hww/SndSynt/doc/pictures/Cartrige Note.gif

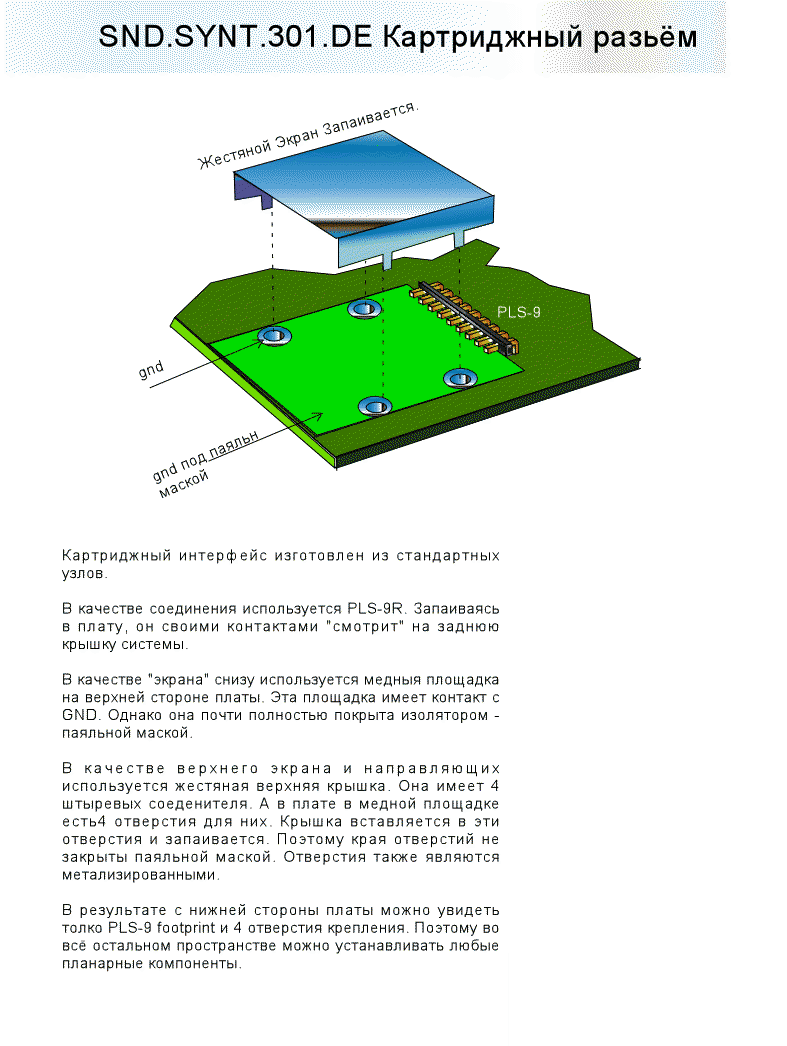
doc/pictures/Cartrige Note.gif
