hww/SndSynt/doc/pictures/FrontPanelDecalA.GIF

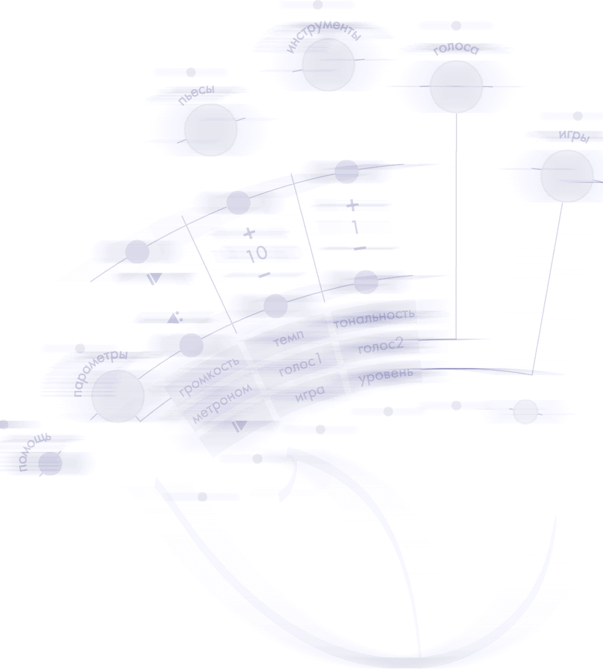
doc/pictures/FrontPanelDecalA.GIF
