hww/SndSynt/doc/pictures/FrontPanelDecalB.GIF

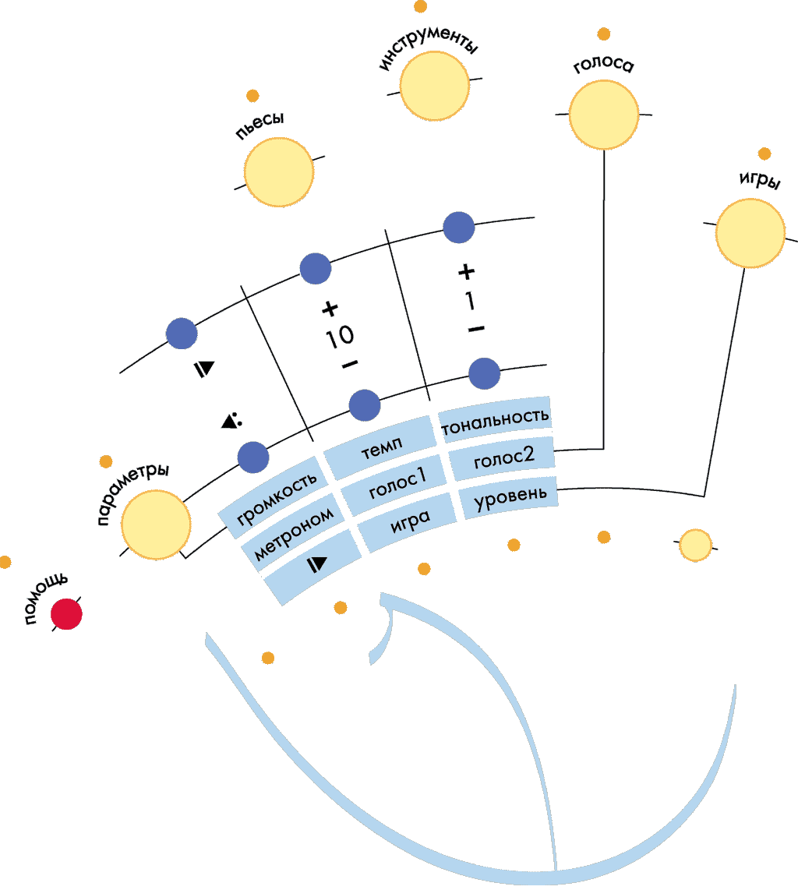
doc/pictures/FrontPanelDecalB.GIF
