hww/SndSynt/doc/pictures/PCB Photo.jpg

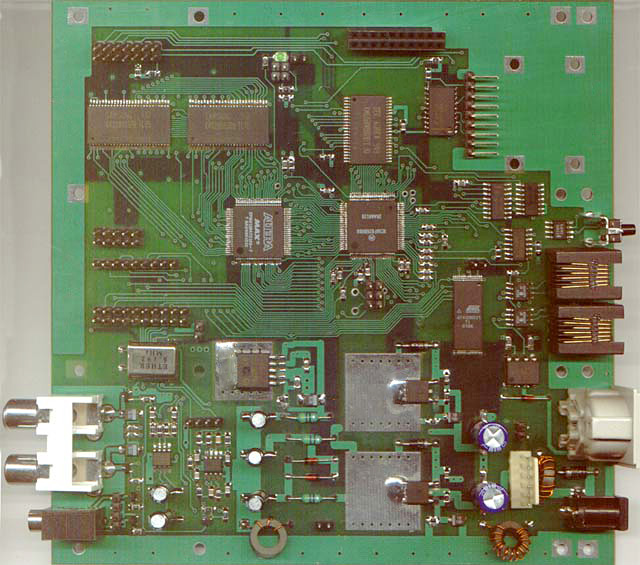
doc/pictures/PCB Photo.jpg
