hww/SndSynt/doc/pdf/logo.pdf

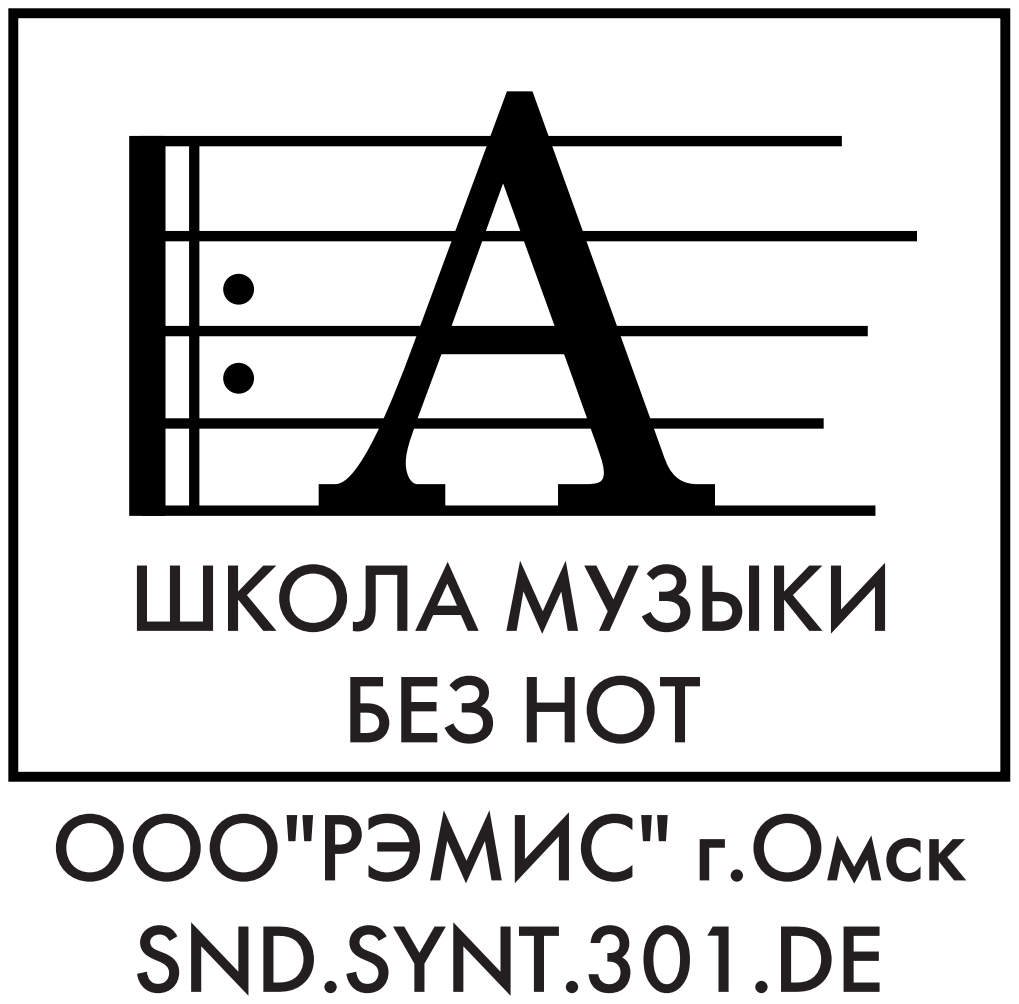
[picture p7: page 1]
