hww/SndSynt/doc/pdf/pkg_SWT157.pdf

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

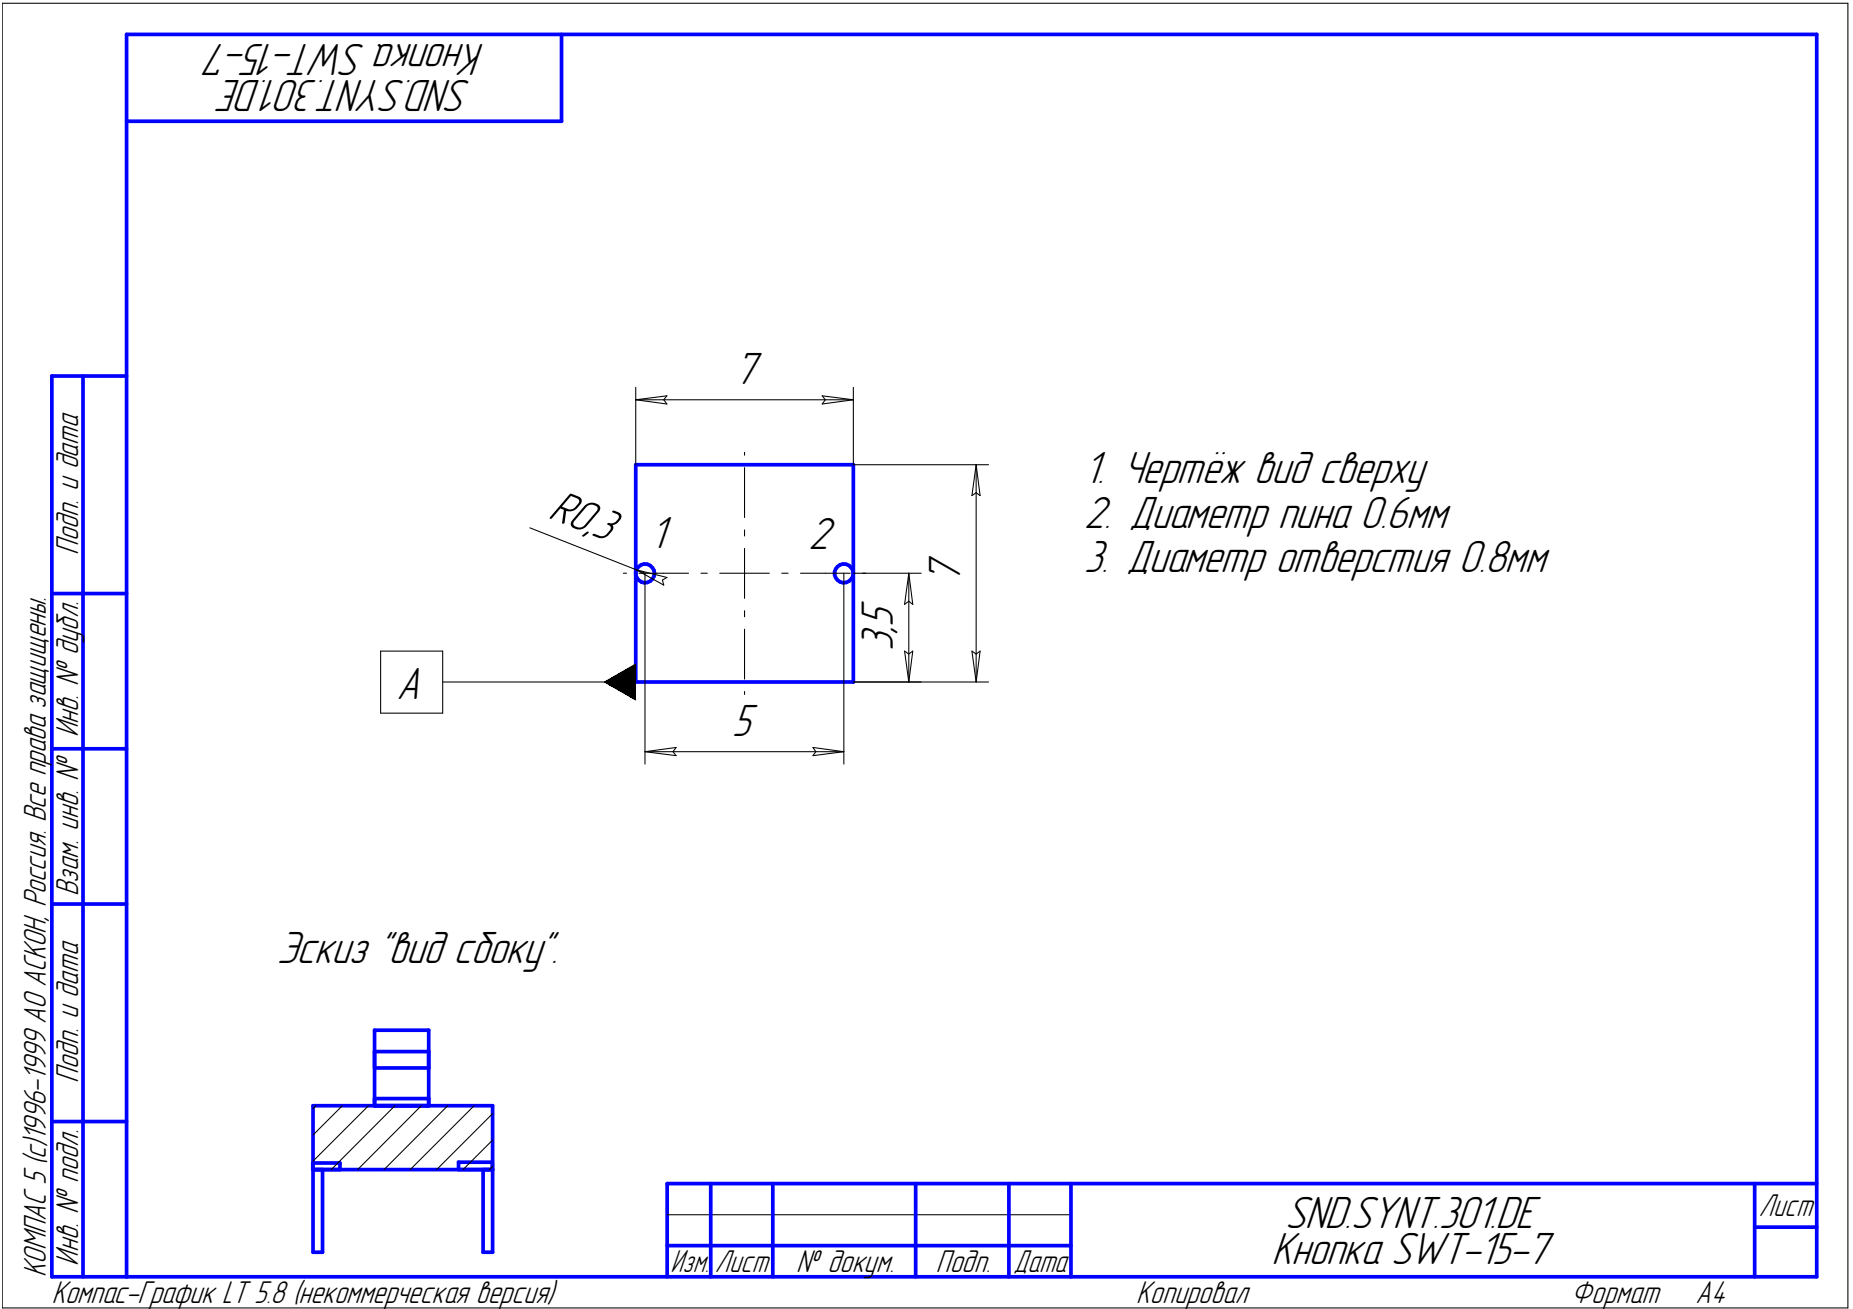
[picture p8: page 1]
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
