hww/SndSynt/doc/TimeDiagrams/sdram_rf_v7.pdf

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

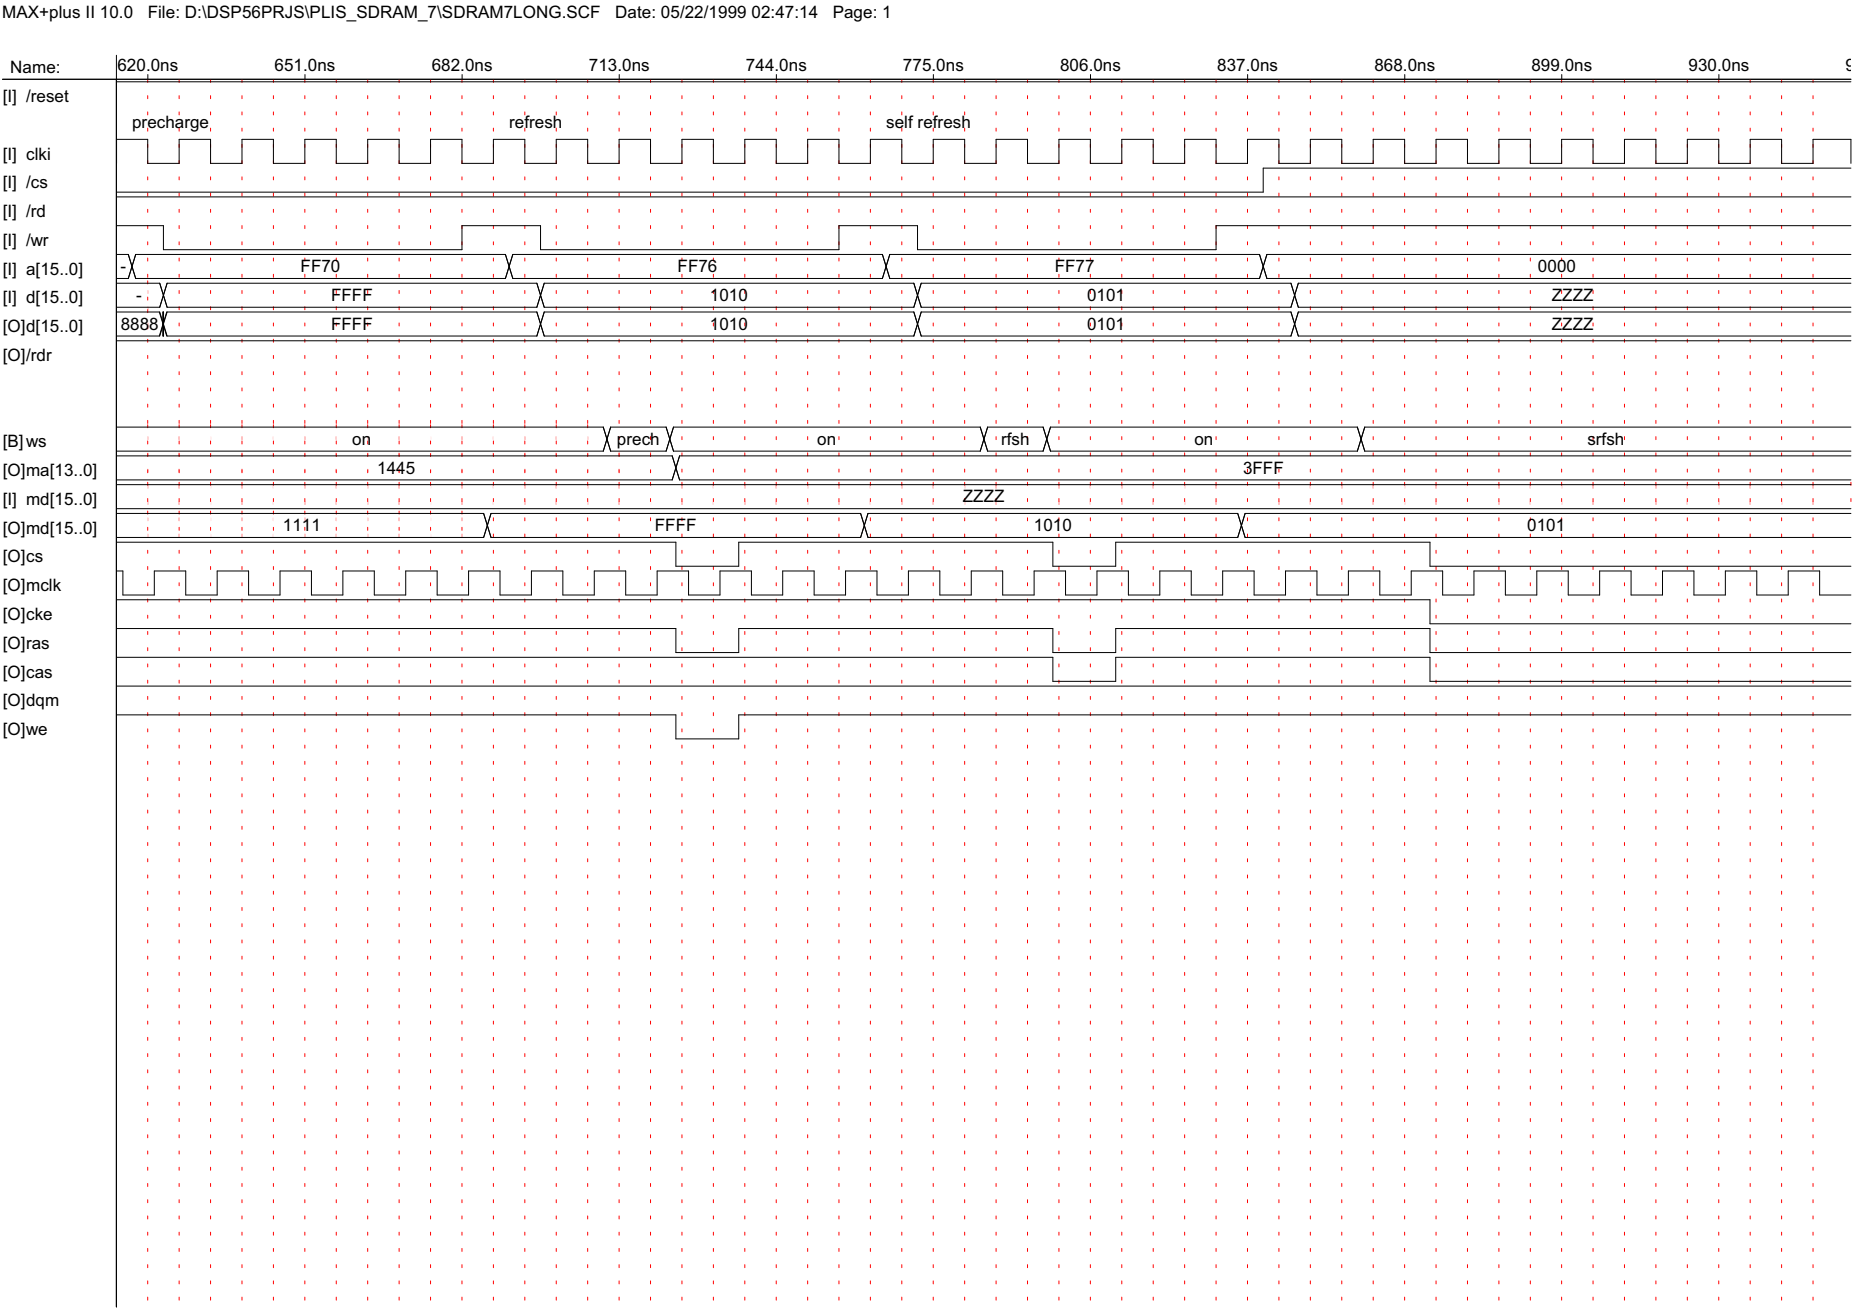
[picture p11: page 1]
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
