hww/SndSynt/doc/pdf/sch/P-CAD EDA - [AMPLIFER].pdf

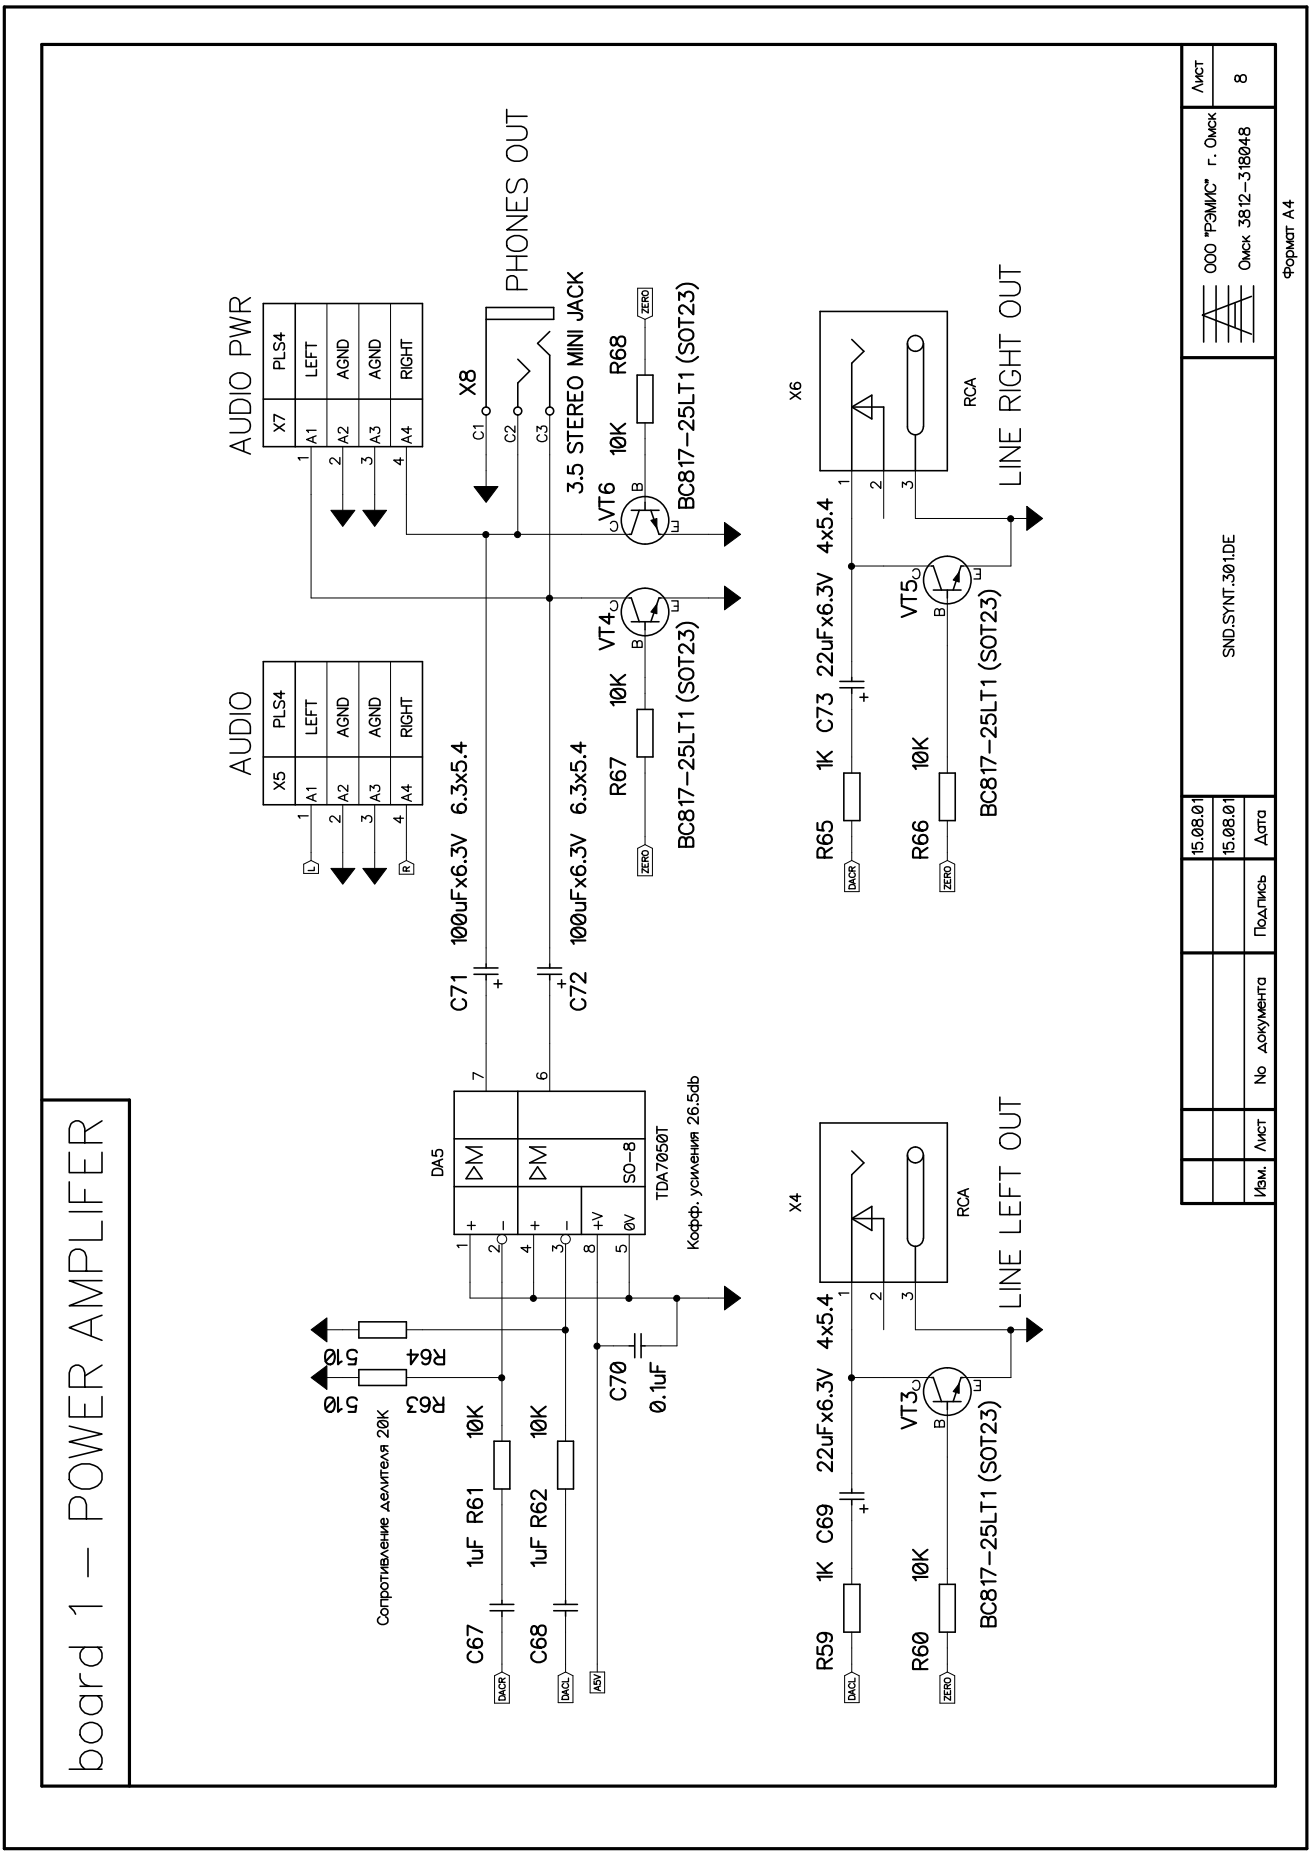
[picture p12: page 1]
