hww/SndSynt/doc/pdf/sch/P-CAD EDA - [CONNECT].pdf

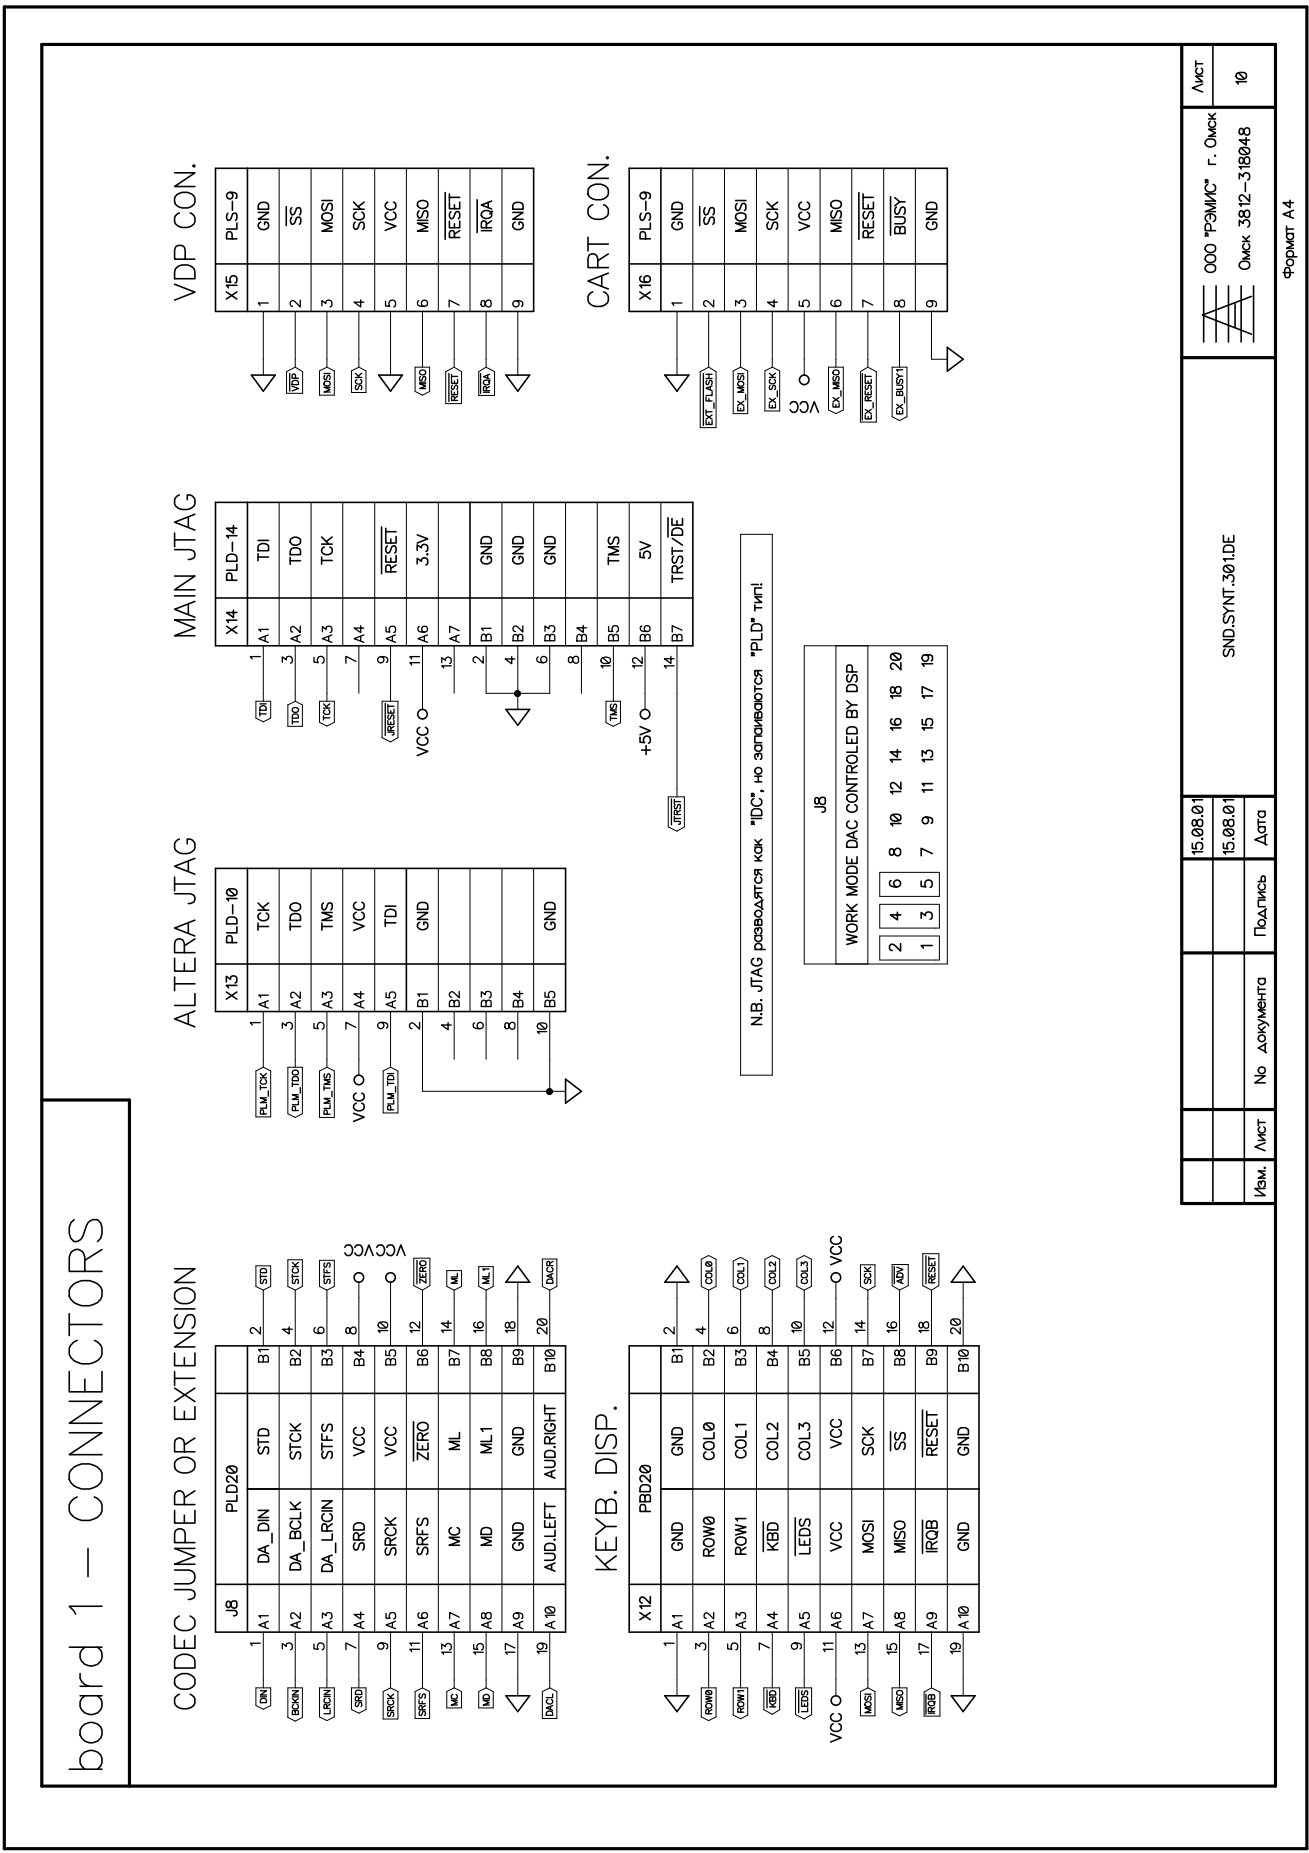
[picture p13: page 1]
