hww/SndSynt/doc/pdf/sch/P-CAD EDA - [DA].pdf

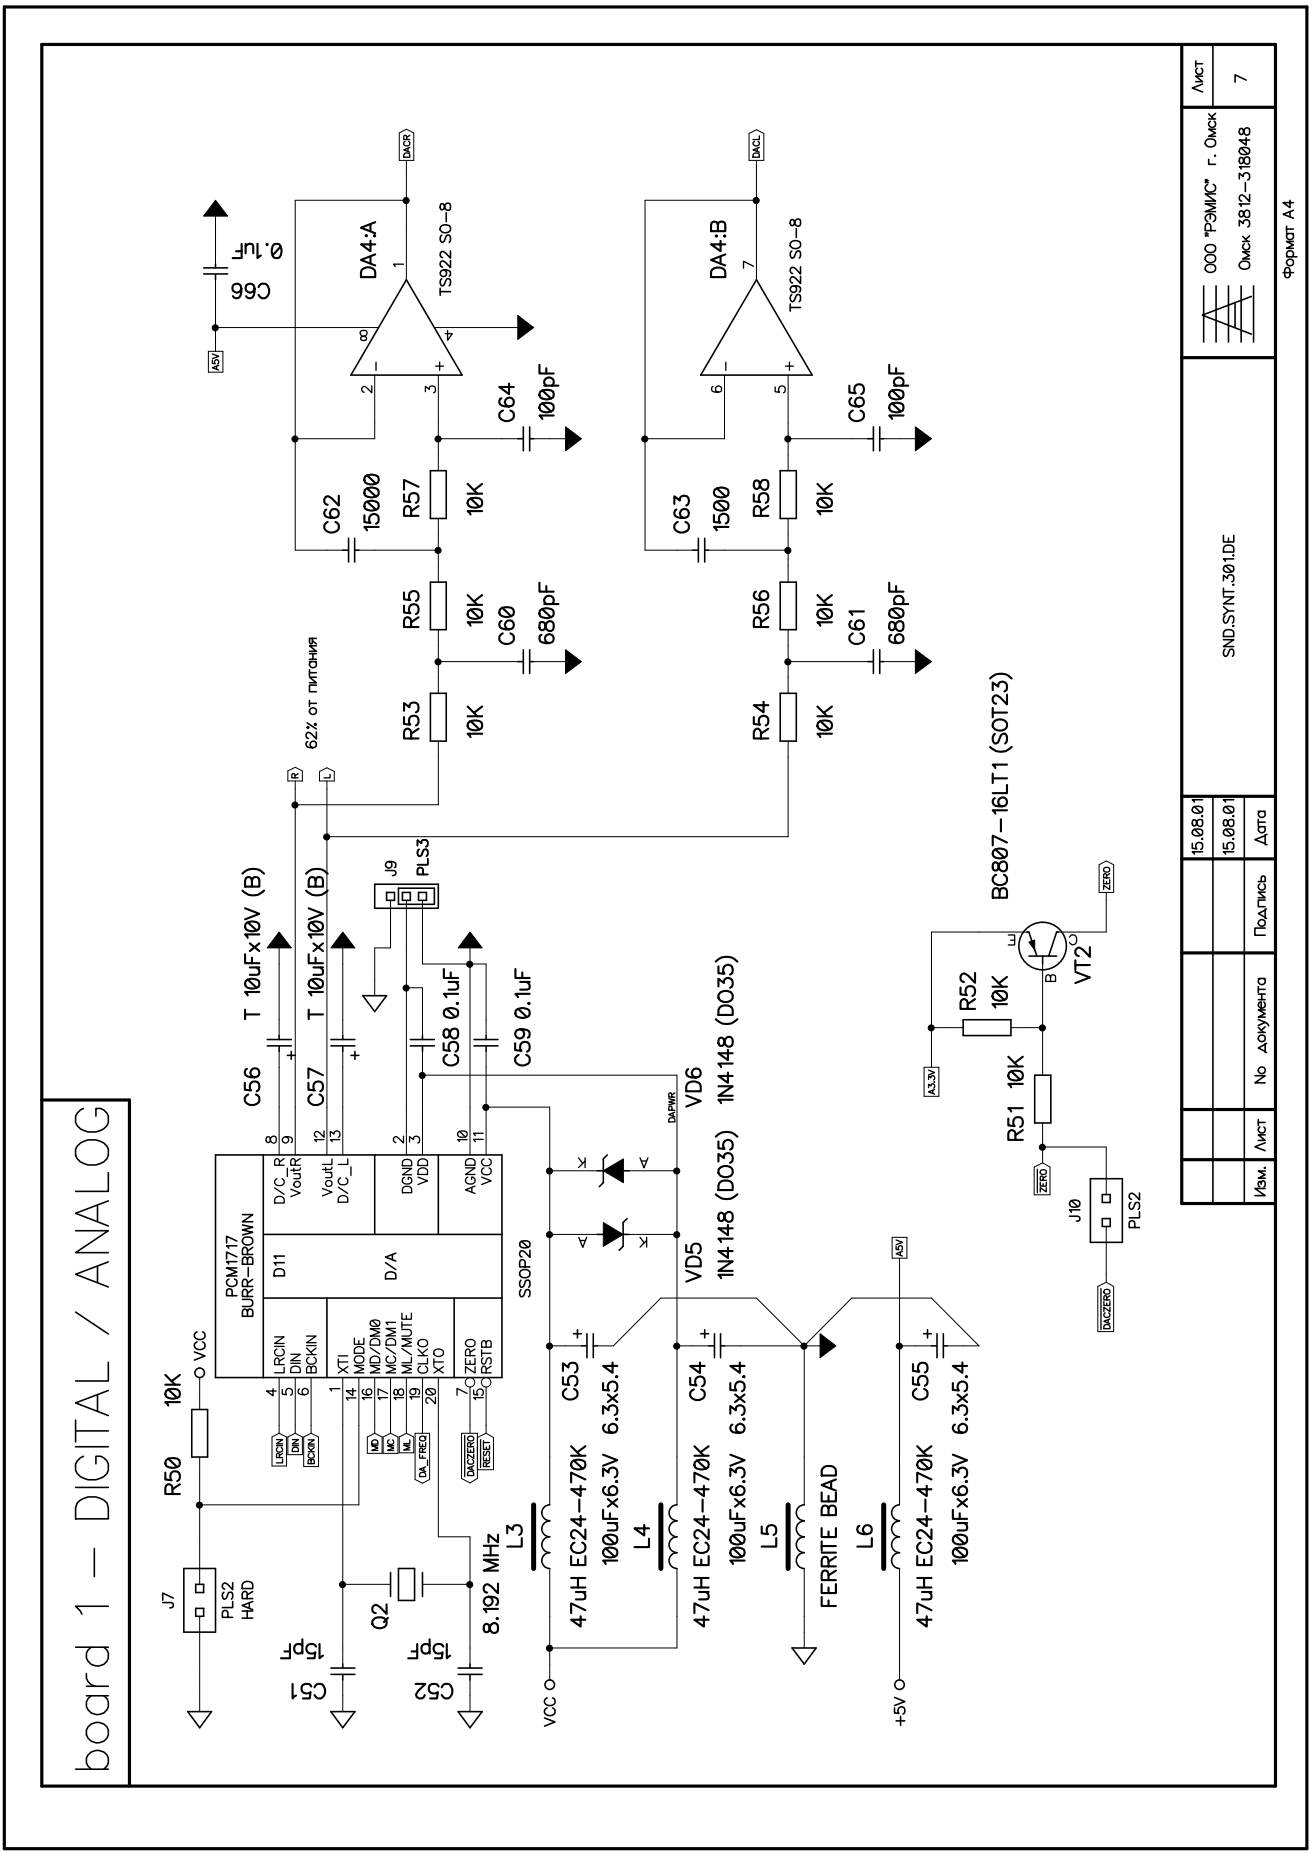
[picture p14: page 1]
