hww/SndSynt/doc/pdf/sch/P-CAD EDA - [DSP].pdf

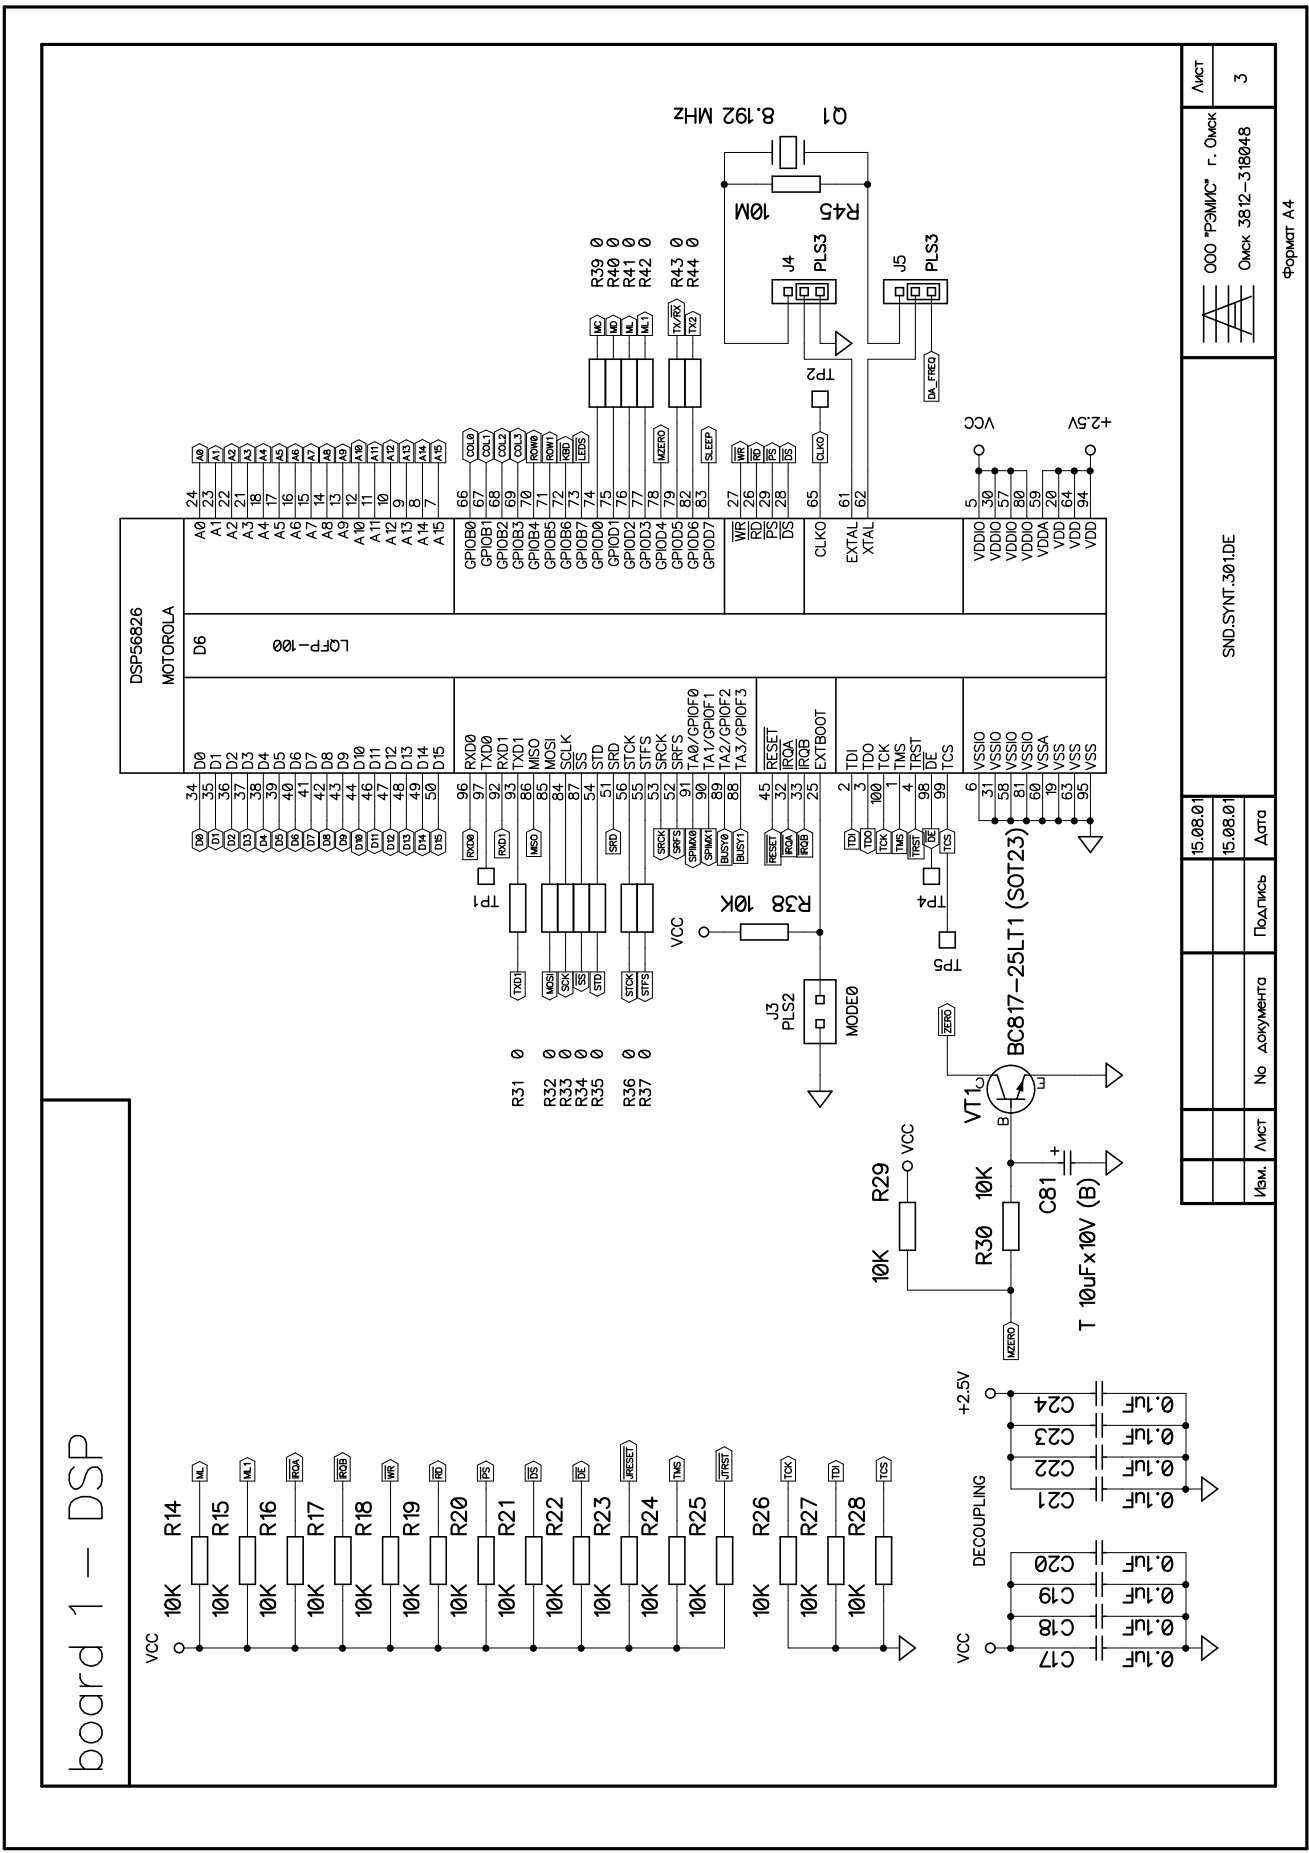
[picture p15: page 1]
