hww/SndSynt/doc/pdf/sch/P-CAD EDA - [GLUE].pdf

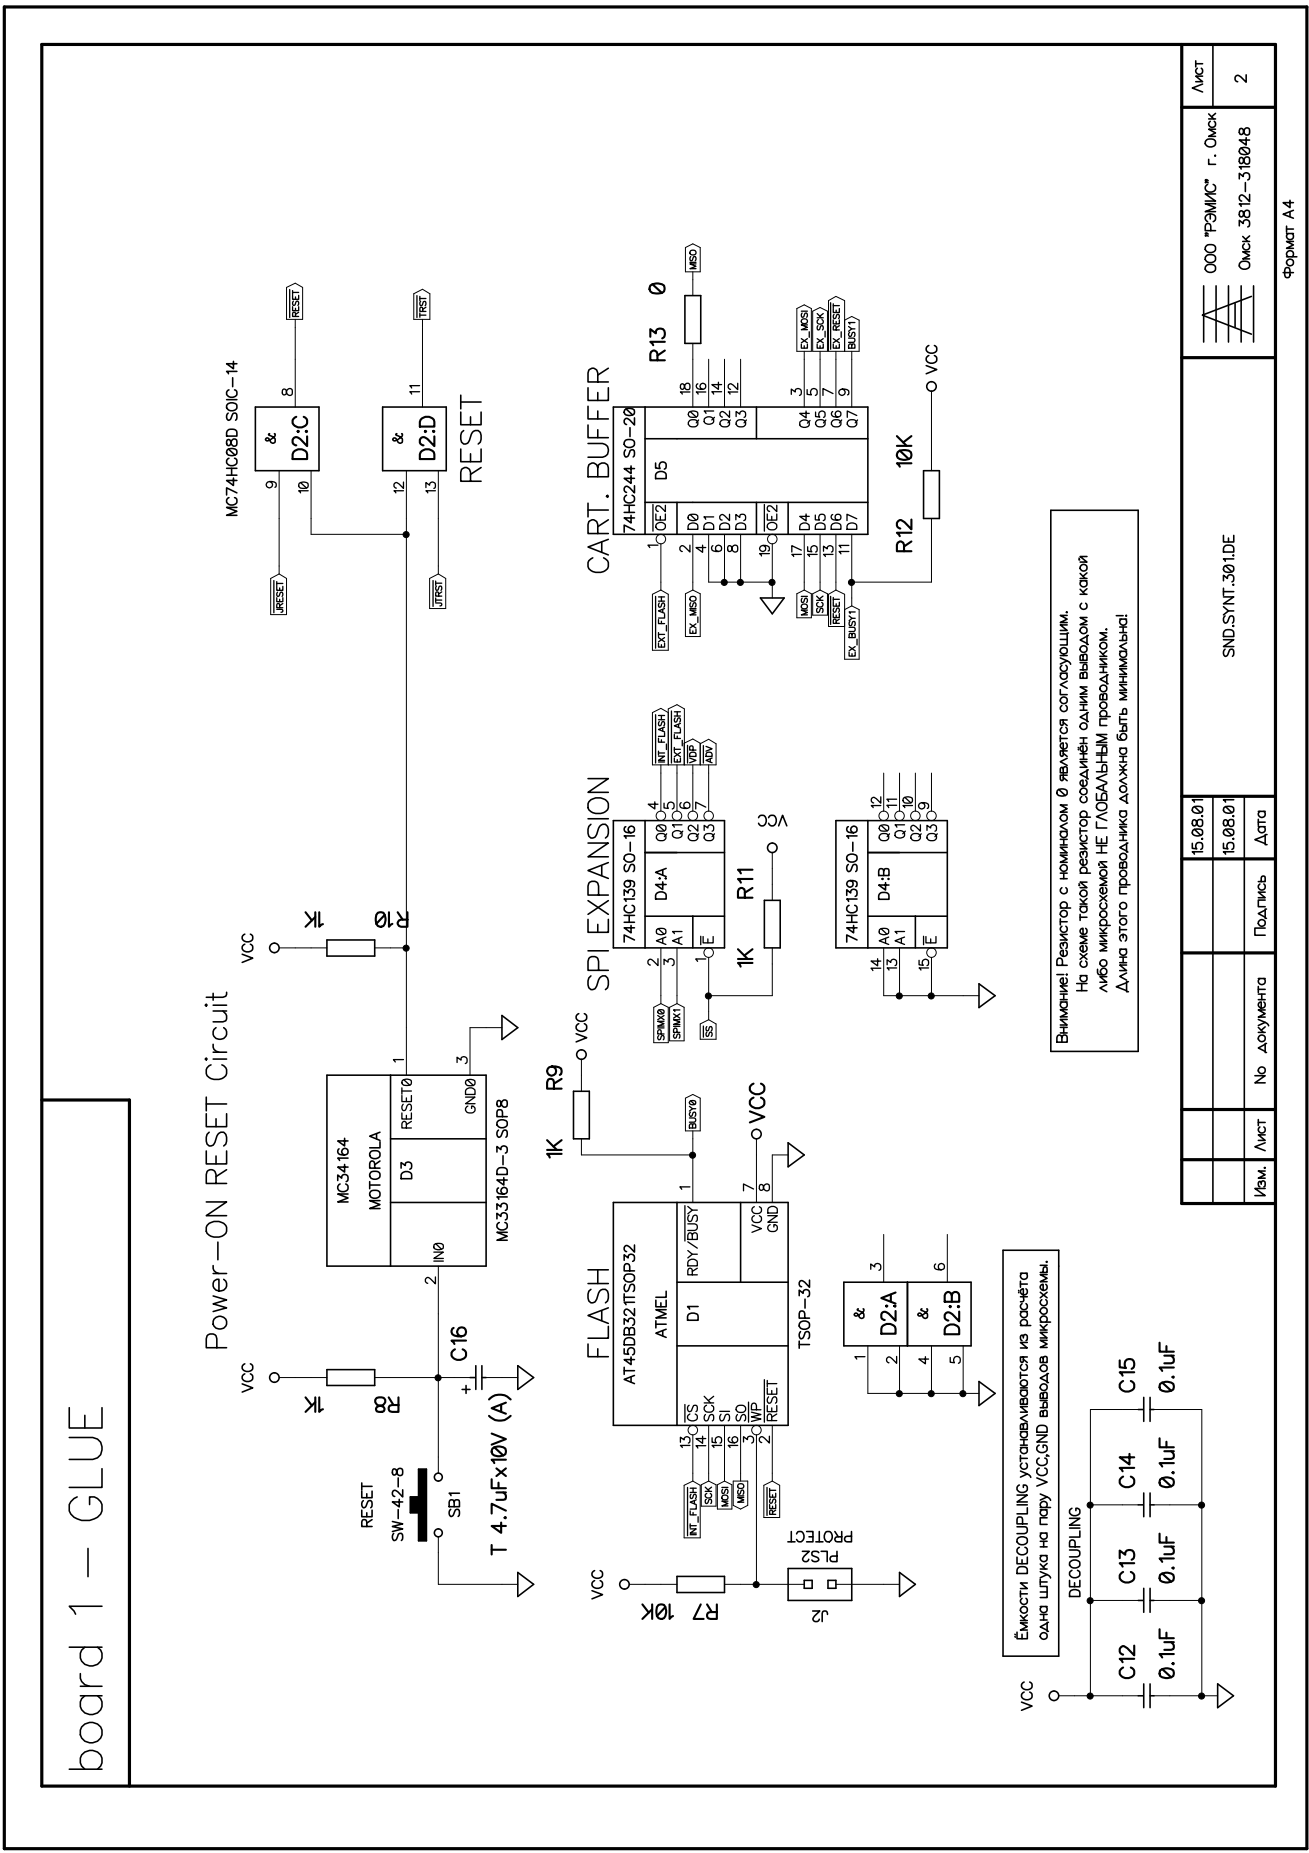
[picture p16: page 1]
