hww/SndSynt/doc/pdf/sch/P-CAD EDA - [I#O_DRVS].pdf

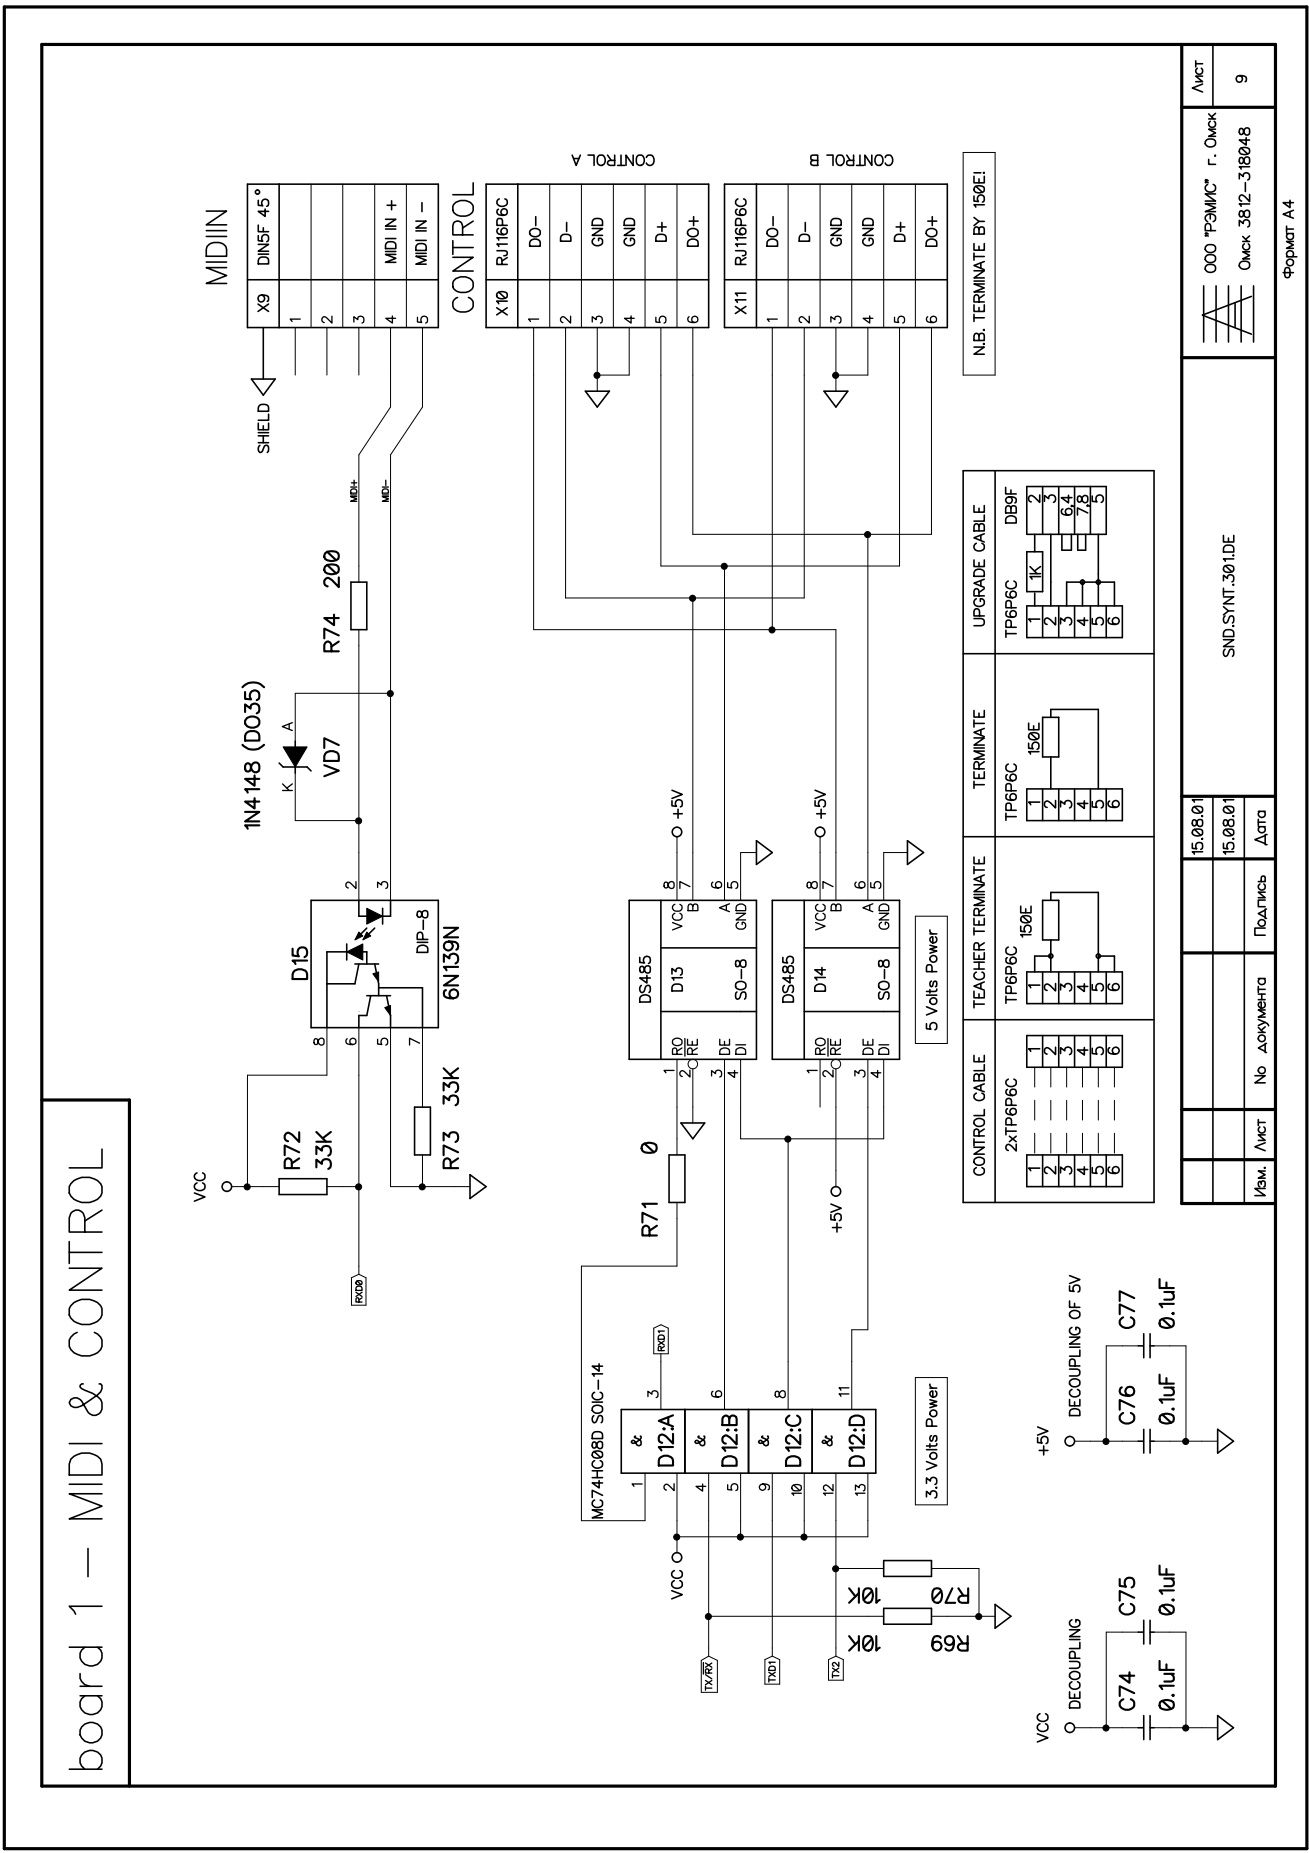
[picture p17: page 1]
