hww/SndSynt/(list of files, drawings)

Other design files:
pcb/Remis_keyb.PCB
pcb/Remis_mc.PCB
