hww/SndSynt/(commit log)

2017-10-08 initial build
    [FINALV4.SCH, Finalv4.sch, Remis_keyb.PCB, Remis_mc.PCB, flash.cfg]
2018-10-08 Remove unused files
    [flash.cfg]
